YixiaoHong/autonomous-maze-solving-rover/README.md

# Autonomous-Maze-Solving-Rover

## video of project:
https://www.youtube.com/watch?v=UskGFBRVmHA

## Breif Introduction of the project
A group project from the course "Mechatronics Systems: Design & Integration". We designed and built an autonomous rover using Arduino as the platform. The rover was able to accomplish the following three tasks during the 5 minutes demo: Firstly, It can localize itself after being placed in a random starting location in the maze. Secondly, The rover can detect and avoid obstacles while maneuvering through the maze. And lastly, the rover can search and pick up a block in the loading zone and deliver the block to the designated drop-off zone. Accomplished an additional task of using Bluetooth module to have the rover communicate with Matlab to achieve real-time inter-program communication and displaying the current location of the rover. 

### Image of the 3D design of the Rover
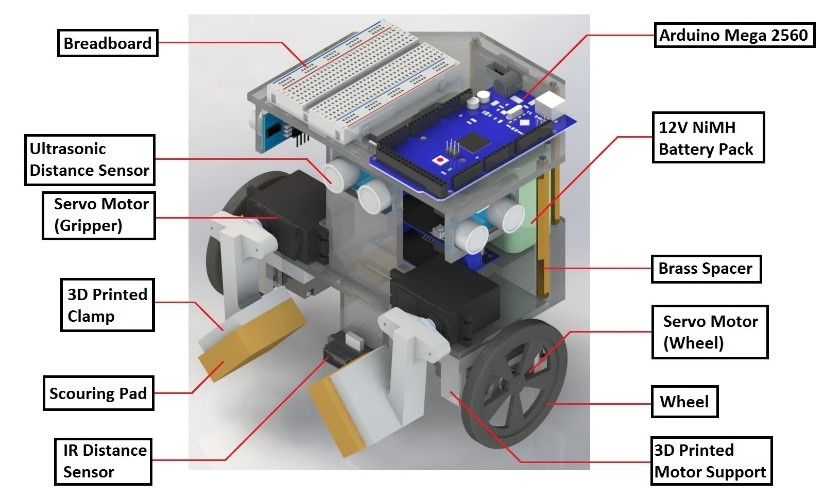
[picture p1: others/design.jpg]


### Image of the Assembled Rover
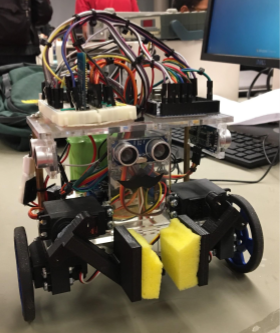
[picture p2: others/rover.png]


## Code
- Main arduino program in folder "rover_arduino_code"
- MATLAB code in folder "matlab_code"

## See "project report.pdf" for more details
